lfochamon/protoarray/Hardware/pics/DSC_0234.jpg

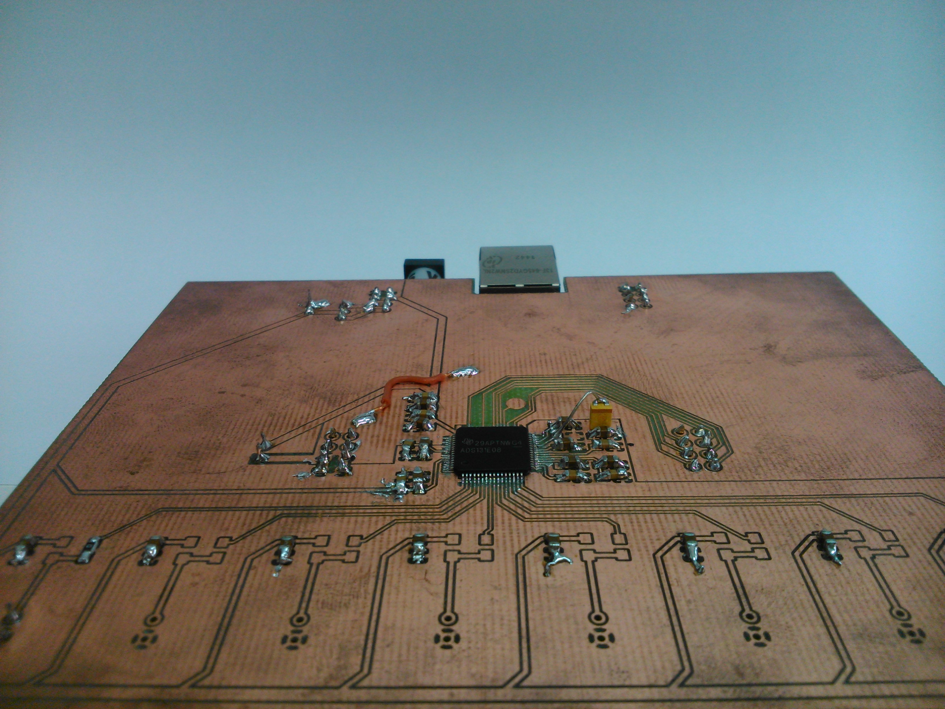
Hardware/pics/DSC_0234.jpg
