lfochamon/protoarray/Hardware/pics/DSC_0238.jpg

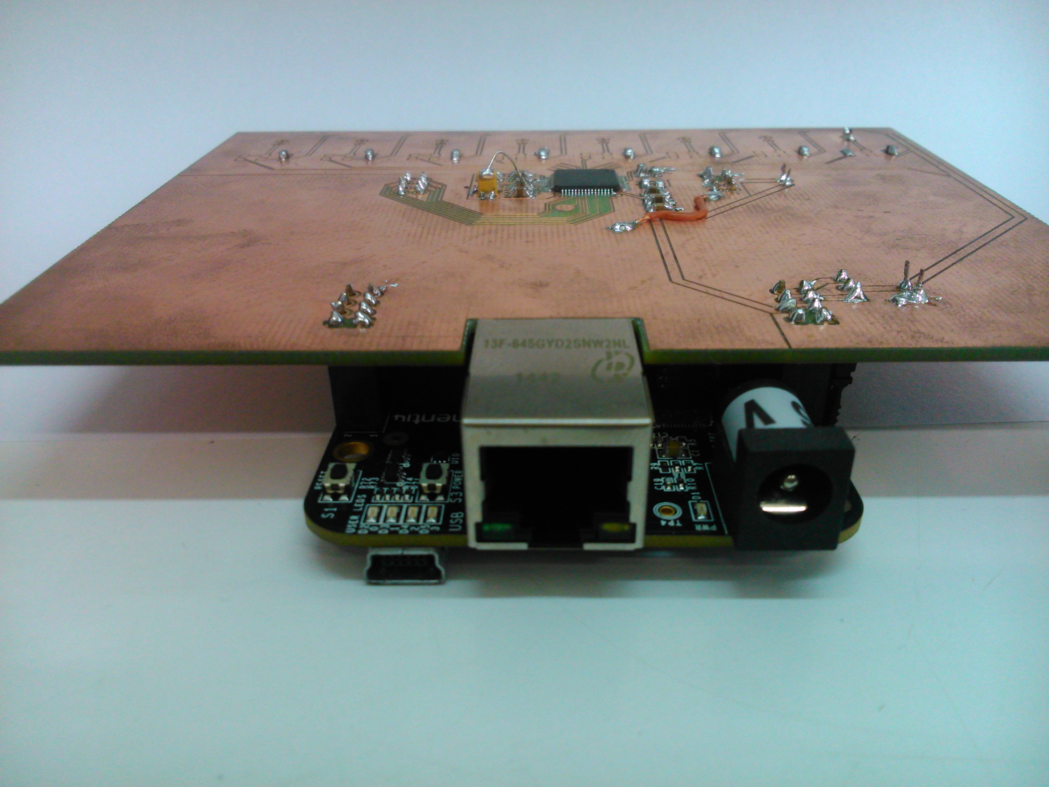
Hardware/pics/DSC_0238.jpg
