lfochamon/protoarray/README.md

# ProtoArray: A prototype microphone array for the BeagleBone Black

This repository contains a prototype ADS131E08 cape for the BBB to be used as a microphone array (or whatever).
