lfochamon/protoarray/Hardware/pics/DSC_0229.jpg

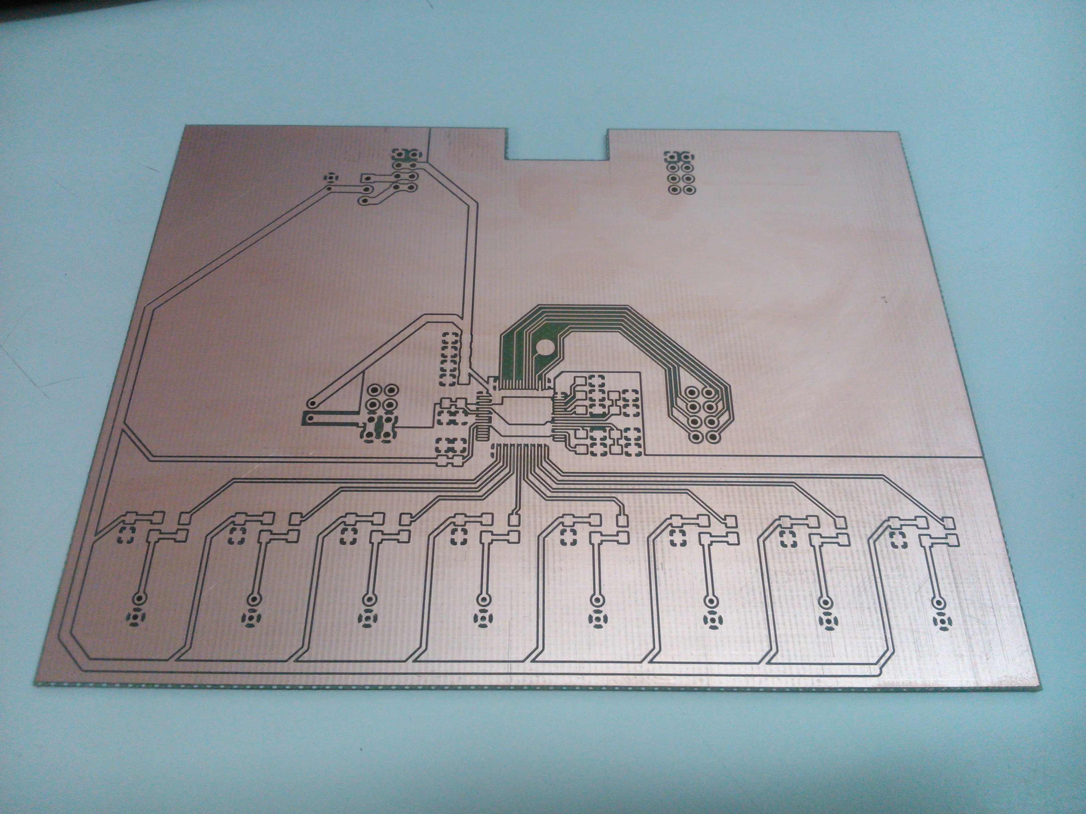
Hardware/pics/DSC_0229.jpg
