lfochamon/protoarray/Hardware/pics/DSC_0231.jpg

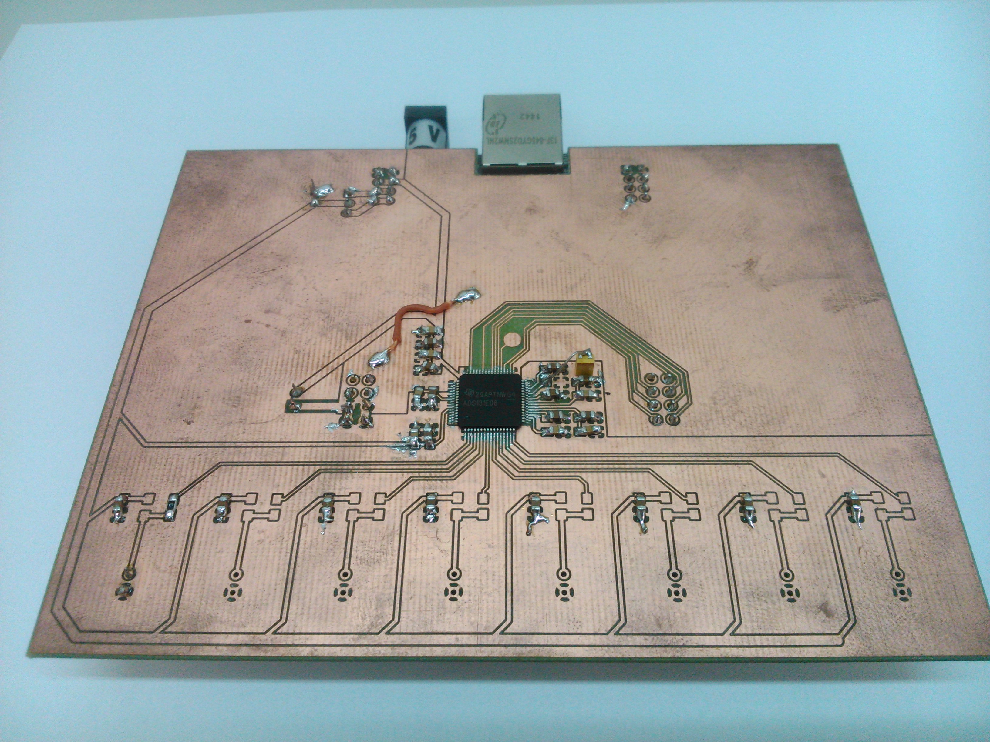
Hardware/pics/DSC_0231.jpg
