lfochamon/protoarray/Hardware/pics/DSC_0240.jpg

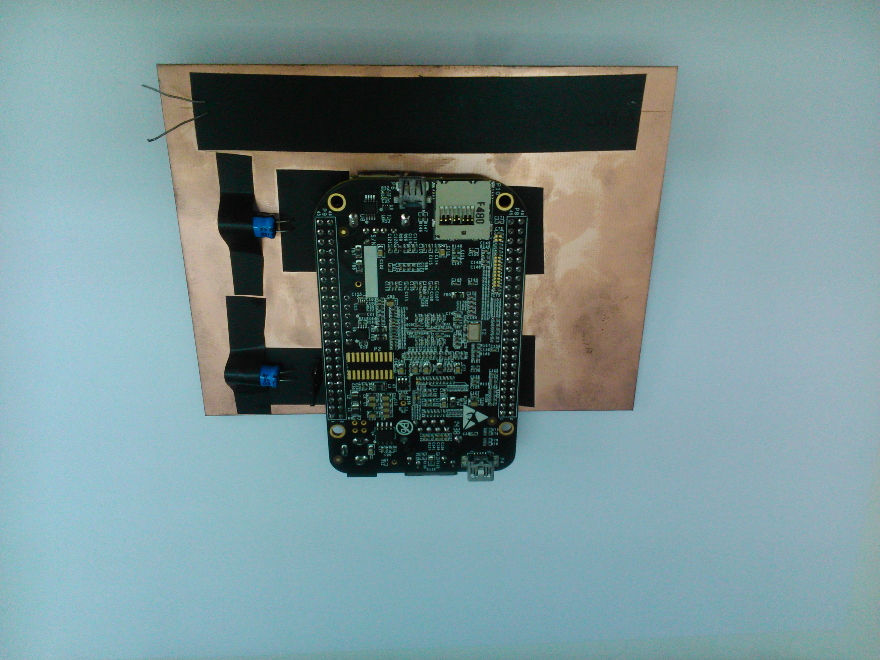
Hardware/pics/DSC_0240.jpg
