lfochamon/protoarray/Hardware/pics/DSC_0241.jpg

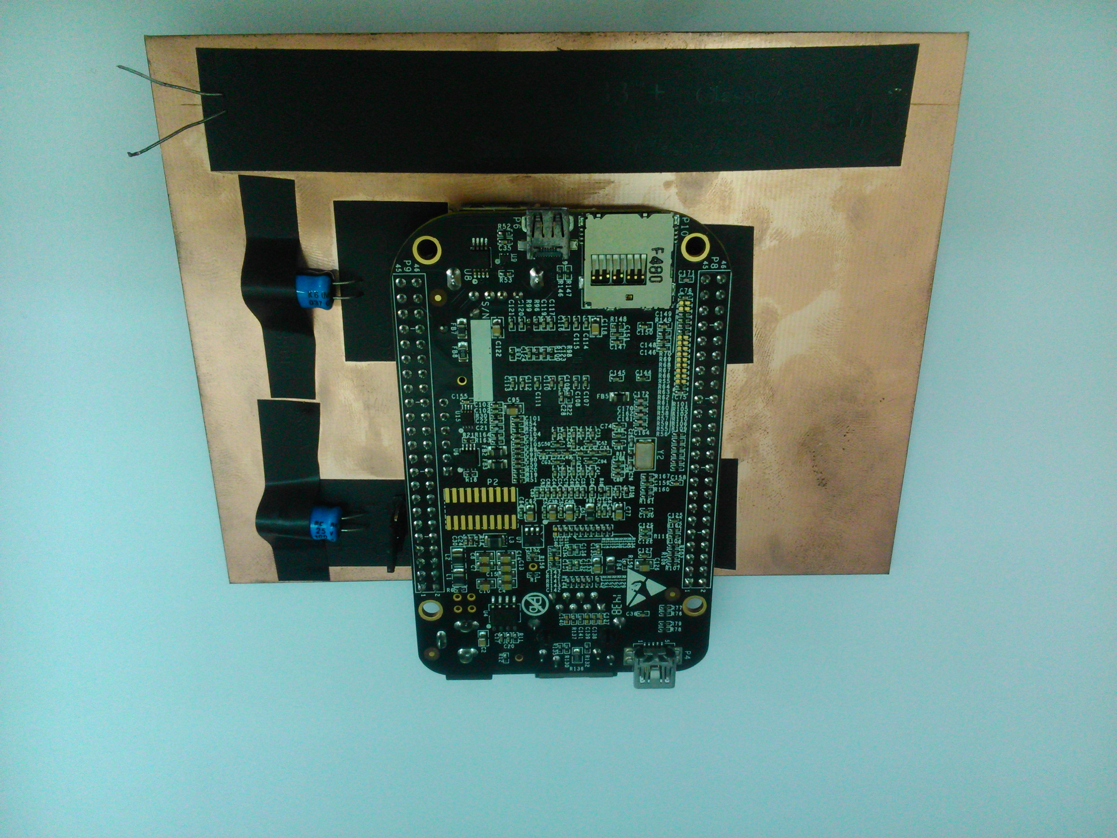
Hardware/pics/DSC_0241.jpg
