lfochamon/protoarray/Hardware/gerber/proto_array-PCB.pdf

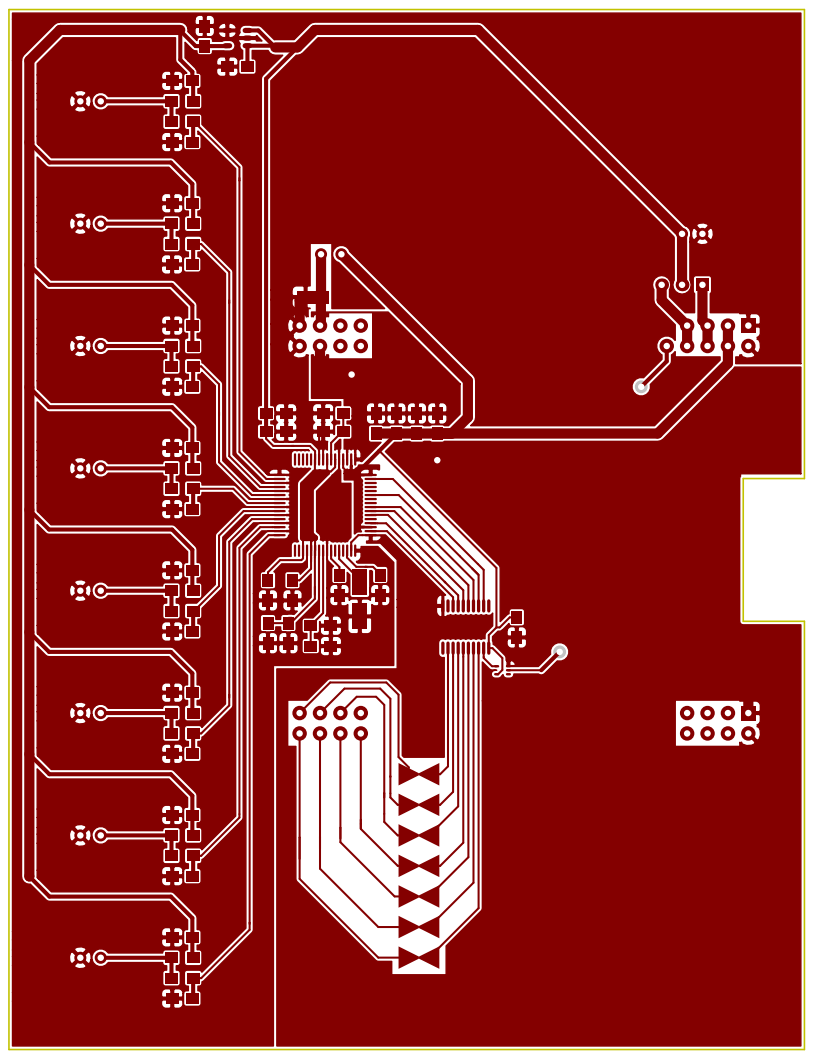
[picture p7: page 1]

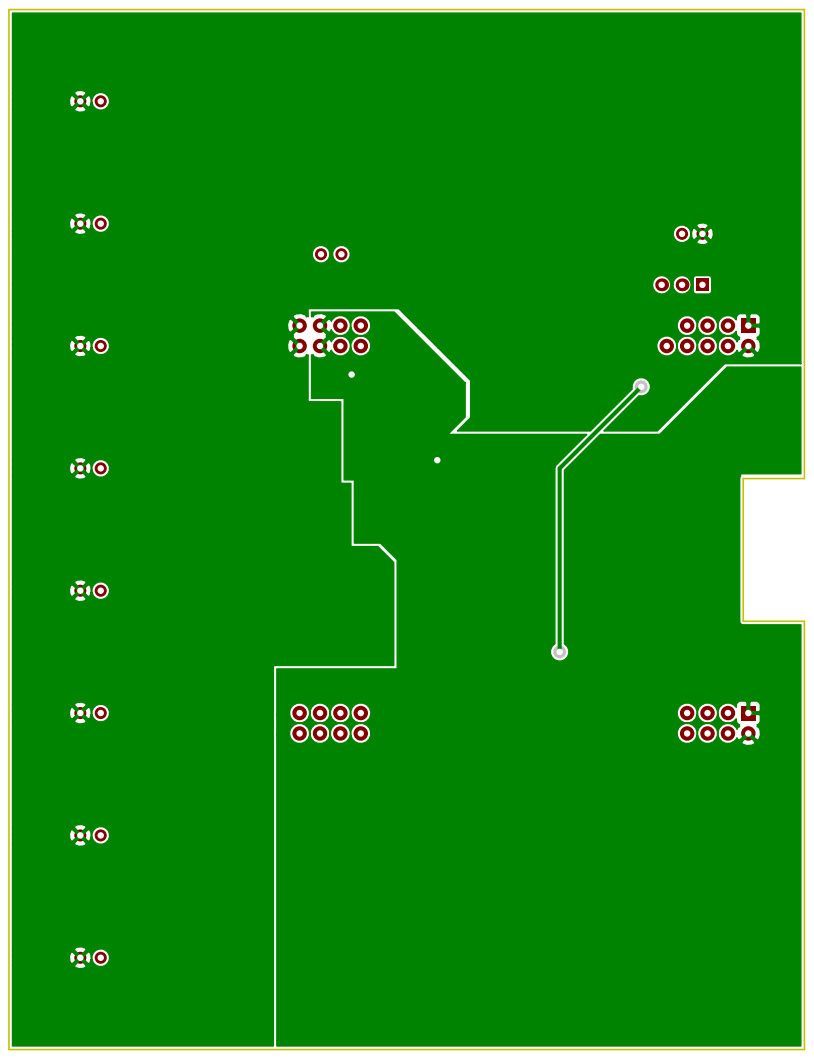
[picture p8: page 2]

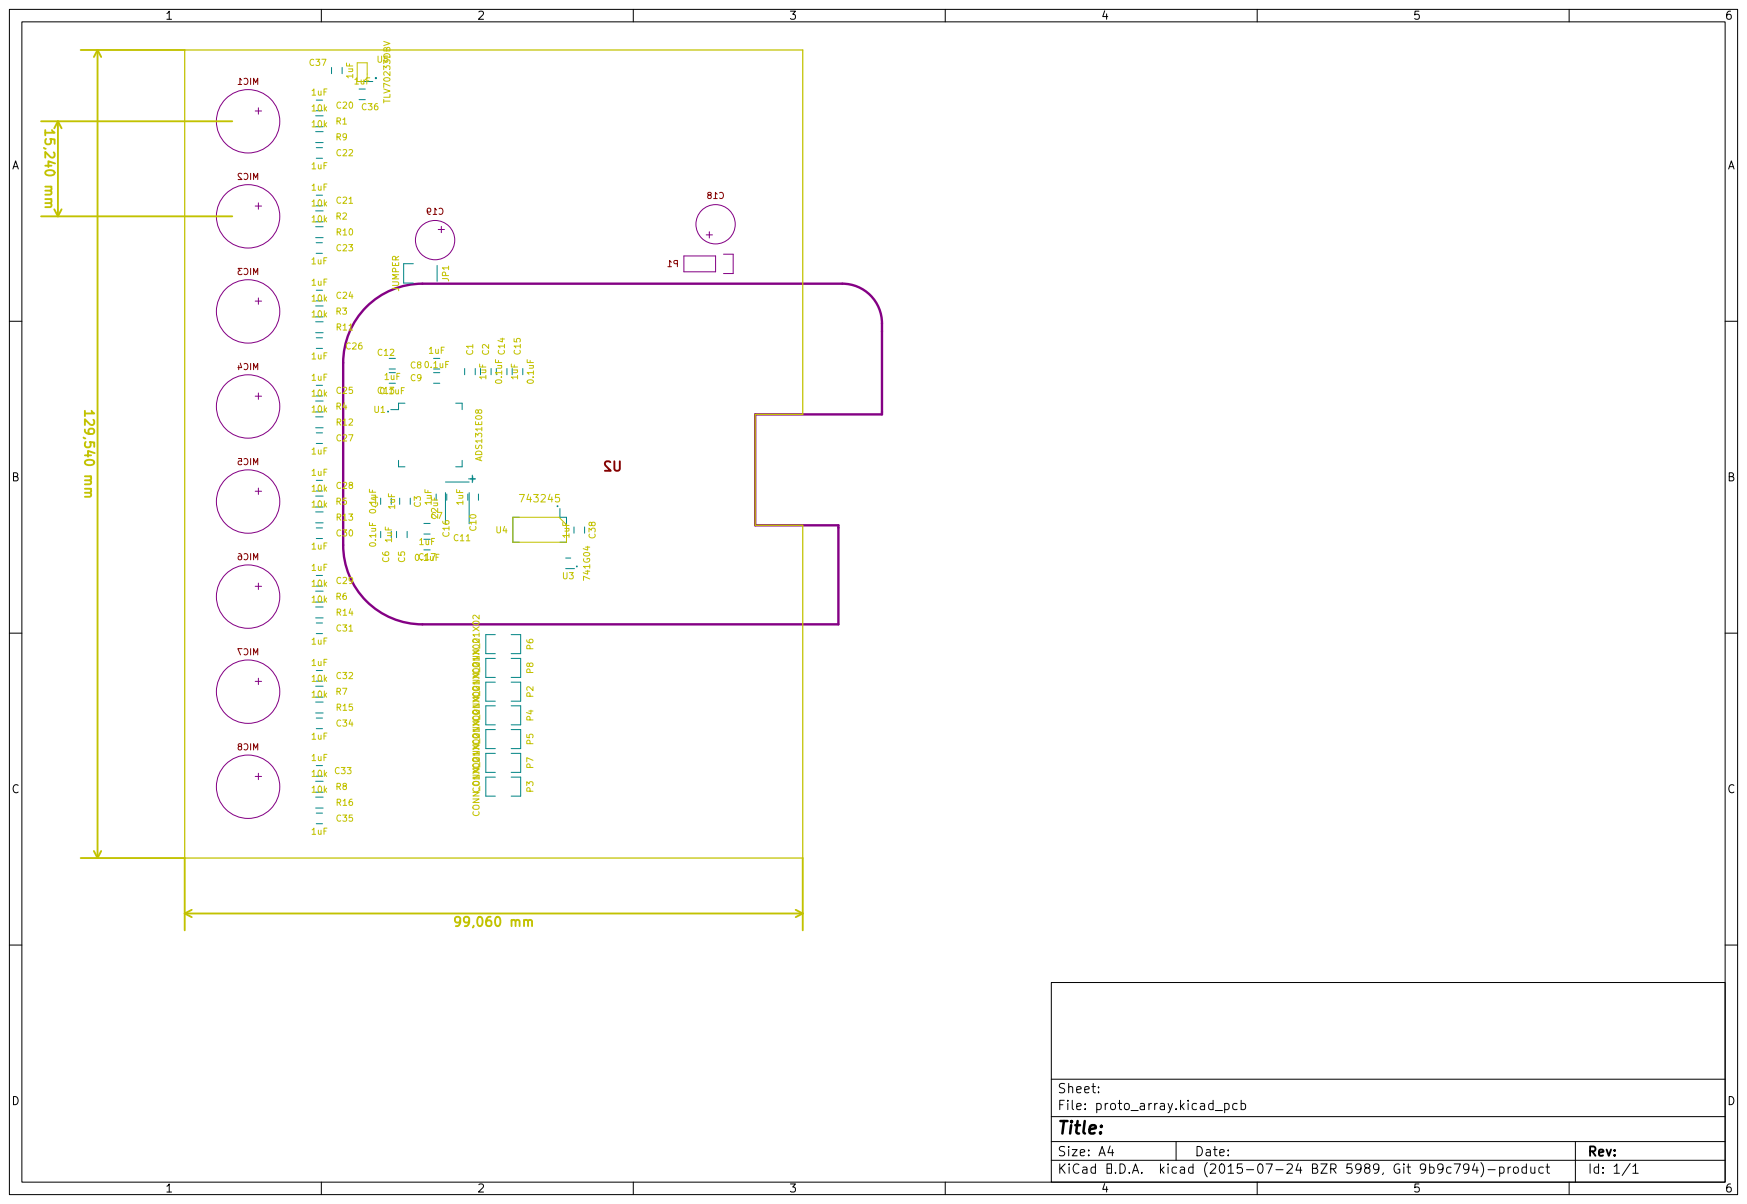
[picture p9: page 3]
