lfochamon/protoarray/Hardware/proto_array.kicad_pcb

## KiCad design Hardware/proto_array.kicad_pcb (2016-02-21)

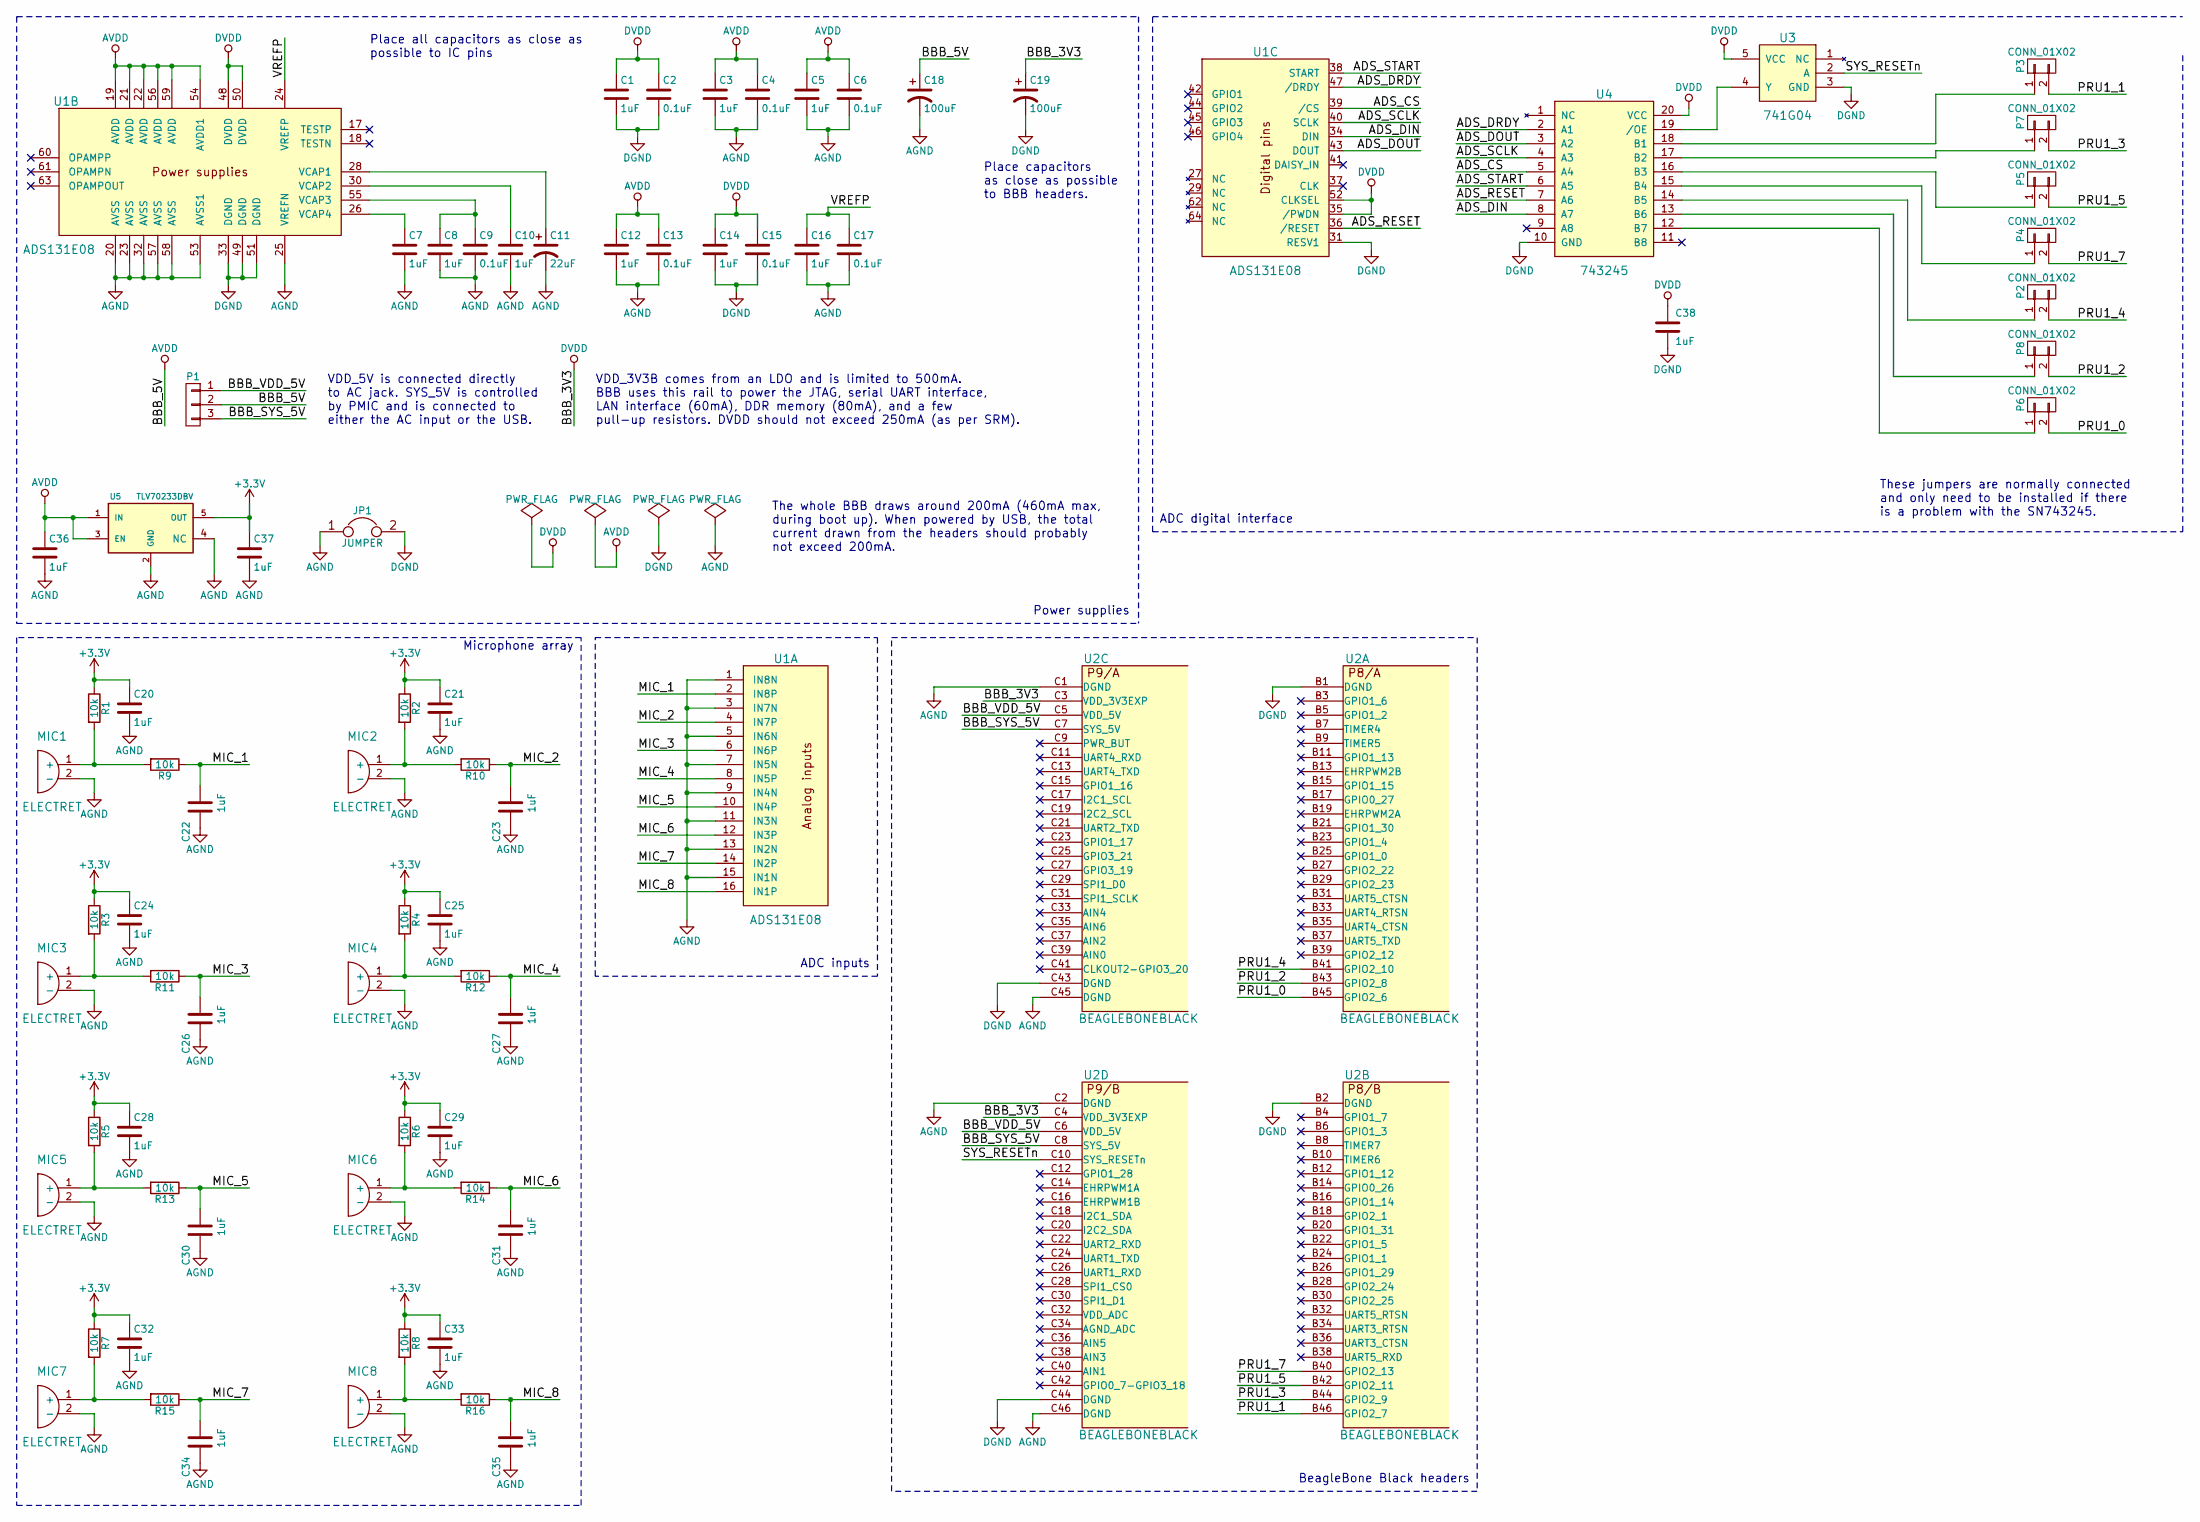
[picture p10: schematic proto_array.sch, Mic array prototype]

Parts:
C1, C3, C5, C7, C8, C10, C12, C14, C16, C20, C21, C22, C23, C24, C25, C26, C27, C28, C29, C30, C31, C32, C33, C34, C35, C36, C37, C38: 1uF; C_0805_HandSoldering
C2, C4, C6, C9, C13, C15, C17: 0.1uF; C_0805_HandSoldering
C11: 22uF; TantalC_SizeB_EIA-3528_HandSoldering
C18, C19: 100uF; Elko_vert_11.2x6.3mm_RM2.5_CopperClear
JP1: JUMPER; Jumper
MIC1, MIC2, MIC3, MIC4, MIC5, MIC6, MIC7, MIC8: ELECTRET; Electret_1mm
P1: CONN_01X03; Pin_Header_01x03
P2, P3, P4, P5, P6, P7, P8: CONN_01X02; Pin_Header_NC_01x02
R1, R2, R3, R4, R5, R6, R7, R8, R9, R10, R11, R12, R13, R14, R15, R16: 10k; R_0805_HandSoldering
U1: ADS131E08; LQFP-64_12x12_Pitch0.5mm_NoFid
U2: BEAGLEBONEBLACK; beagleboneblack_custom
U3: 741G04; SOTFL-5_160x50_Pitch0.5
U4: 743245; SOP-20_600x175_Pitch0.635
U5: TLV70233DBV; SOT-23-5

Connections:
+3V3: C20.1, C21.1, C24.1, C25.1, C28.1, C29.1, C32.1, C33.1, C37.1, R1.1, R2.1, R3.1, R4.1, R5.1, R6.1, R7.1, R8.1, U5.5 (OUT)
/ADS_CS: U1.39 (/CS), U4.5 (A4)
/ADS_DIN: U1.34 (DIN), U4.8 (A7)
/ADS_DOUT: U1.43 (DOUT), U4.3 (A2)
/ADS_DRDY: U1.47 (/DRDY), U4.2 (A1)
/ADS_RESET: U1.36 (/RESET), U4.7 (A6)
/ADS_SCLK: U1.40 (SCLK), U4.4 (A3)
/ADS_START: U1.38 (START), U4.6 (A5)
/BBB_SYS_5V: P1.3, U2.C7 (SYS_5V), U2.C8 (SYS_5V)
/BBB_VDD_5V: P1.1, U2.C5 (VDD_5V), U2.C6 (VDD_5V)
/MIC_1: C22.2, R9.1, U1.2 (IN8P)
/MIC_2: C23.2, R10.1, U1.4 (IN7P)
/MIC_3: C26.2, R11.1, U1.6 (IN6P)
/MIC_4: C27.2, R12.1, U1.8 (IN5P)
/MIC_5: C30.2, R13.1, U1.10 (IN4P)
/MIC_6: C31.2, R14.1, U1.12 (IN3P)
/MIC_7: C34.2, R15.1, U1.14 (IN2P)
/MIC_8: C35.2, R16.1, U1.16 (IN1P)
/PRU1_0: P6.2, U2.B45 (GPIO2_6)
/PRU1_1: P3.2, U2.B46 (GPIO2_7)
/PRU1_2: P8.2, U2.B43 (GPIO2_8)
/PRU1_3: P7.2, U2.B44 (GPIO2_9)
/PRU1_4: P2.2, U2.B41 (GPIO2_10)
/PRU1_5: P5.2, U2.B42 (GPIO2_11)
/PRU1_7: P4.2, U2.B40 (GPIO2_13)
/SYS_RESETn: U2.C10 (SYS_RESETn), U3.2 (A)
/VREFP: C16.1, C17.1, U1.24 (VREFP)
AGND: C3.2, C4.2, C5.2, C6.2, C7.2, C8.2, C9.2, C10.2, C11.2, C12.2, C13.2, C16.2, C17.2, C18.2, C20.2, C21.2, C22.1, C23.1, C24.2, C25.2, C26.1, C27.1, C28.2, C29.2, C30.1, C31.1, C32.2, C33.2, C34.1, C35.1, C36.2, C37.2, JP1.1, MIC1.2 (-), MIC2.2 (-), MIC3.2 (-), MIC4.2 (-), MIC5.2 (-), MIC6.2 (-), MIC7.2 (-), MIC8.2 (-), U1.1 (IN8N), U1.3 (IN7N), U1.5 (IN6N), U1.7 (IN5N), U1.9 (IN4N), U1.11 (IN3N), U1.13 (IN2N), U1.15 (IN1N), U1.20 (AVSS), U1.23 (AVSS), U1.25 (VREFN), U1.32 (AVSS), U1.53 (AVSS1), U1.57 (AVSS), U1.58 (AVSS), U2.C1 (DGND), U2.C2 (DGND), U2.C45 (DGND), U2.C46 (DGND), U5.2 (GND), U5.4 (NC)
AVDD: C3.1, C4.1, C5.1, C6.1, C12.1, C13.1, C18.1, C36.1, P1.2, U1.19 (AVDD), U1.21 (AVDD), U1.22 (AVDD), U1.54 (AVDD1), U1.56 (AVDD), U1.59 (AVDD), U5.1 (IN), U5.3 (EN)
DGND: C1.2, C2.2, C14.2, C15.2, C19.2, C38.2, JP1.2, U1.31 (RESV1), U1.33 (DGND), U1.49 (DGND), U1.51 (DGND), U2.B1 (DGND), U2.B2 (DGND), U2.C43 (DGND), U2.C44 (DGND), U3.3 (GND), U4.10 (GND)
DVDD: C1.1, C2.1, C14.1, C15.1, C19.1, C38.1, U1.35 (/PWDN), U1.48 (DVDD), U1.50 (DVDD), U1.52 (CLKSEL), U2.C3 (VDD_3V3EXP), U2.C4 (VDD_3V3EXP), U3.5 (VCC), U4.20 (VCC)
unnamed: C7.1, U1.26 (VCAP4)
unnamed: C8.1, C9.1, U1.55 (VCAP3)
unnamed: C10.1, U1.30 (VCAP2)
unnamed: C11.1, U1.28 (VCAP1)
unnamed: MIC1.1 (+), R1.2, R9.2
unnamed: MIC2.1 (+), R2.2, R10.2
unnamed: MIC3.1 (+), R3.2, R11.2
unnamed: MIC4.1 (+), R4.2, R12.2
unnamed: MIC5.1 (+), R5.2, R13.2
unnamed: MIC6.1 (+), R6.2, R14.2
unnamed: MIC7.1 (+), R7.2, R15.2
unnamed: MIC8.1 (+), R8.2, R16.2
unnamed: P2.1, U4.14 (B5)
unnamed: P3.1, U4.18 (B1)
unnamed: P4.1, U4.15 (B4)
unnamed: P5.1, U4.16 (B3)
unnamed: P6.1, U4.12 (B7)
unnamed: P7.1, U4.17 (B2)
unnamed: P8.1, U4.13 (B6)
unnamed: U3.4 (Y), U4.19 (/OE)

Notes on the sheet:
Place all capacitors as close as possible to IC pins
Power supplies
Microphone array
ADC inputs
BeagleBone Black headers
ADC digital interface
VDD_5V is connected directly to AC jack. SYS_5V is controlled by PMIC and is connected to either the AC input or the USB.
VDD_3V3B comes from an LDO and is limited to 500mA. BBB uses this rail to power the JTAG, serial UART interface, LAN interface (60mA), DDR memory (80mA), and a few pull-up resistors. DVDD should not exceed 250mA (as per SRM).
The whole BBB draws around 200mA (460mA max, during boot up). When powered by USB, the total current drawn from the headers should probably not exceed 200mA.
Place capacitors as close as possible to BBB headers.
These jumpers are normally connected and only need to be installed if there is a problem with the SN743245.

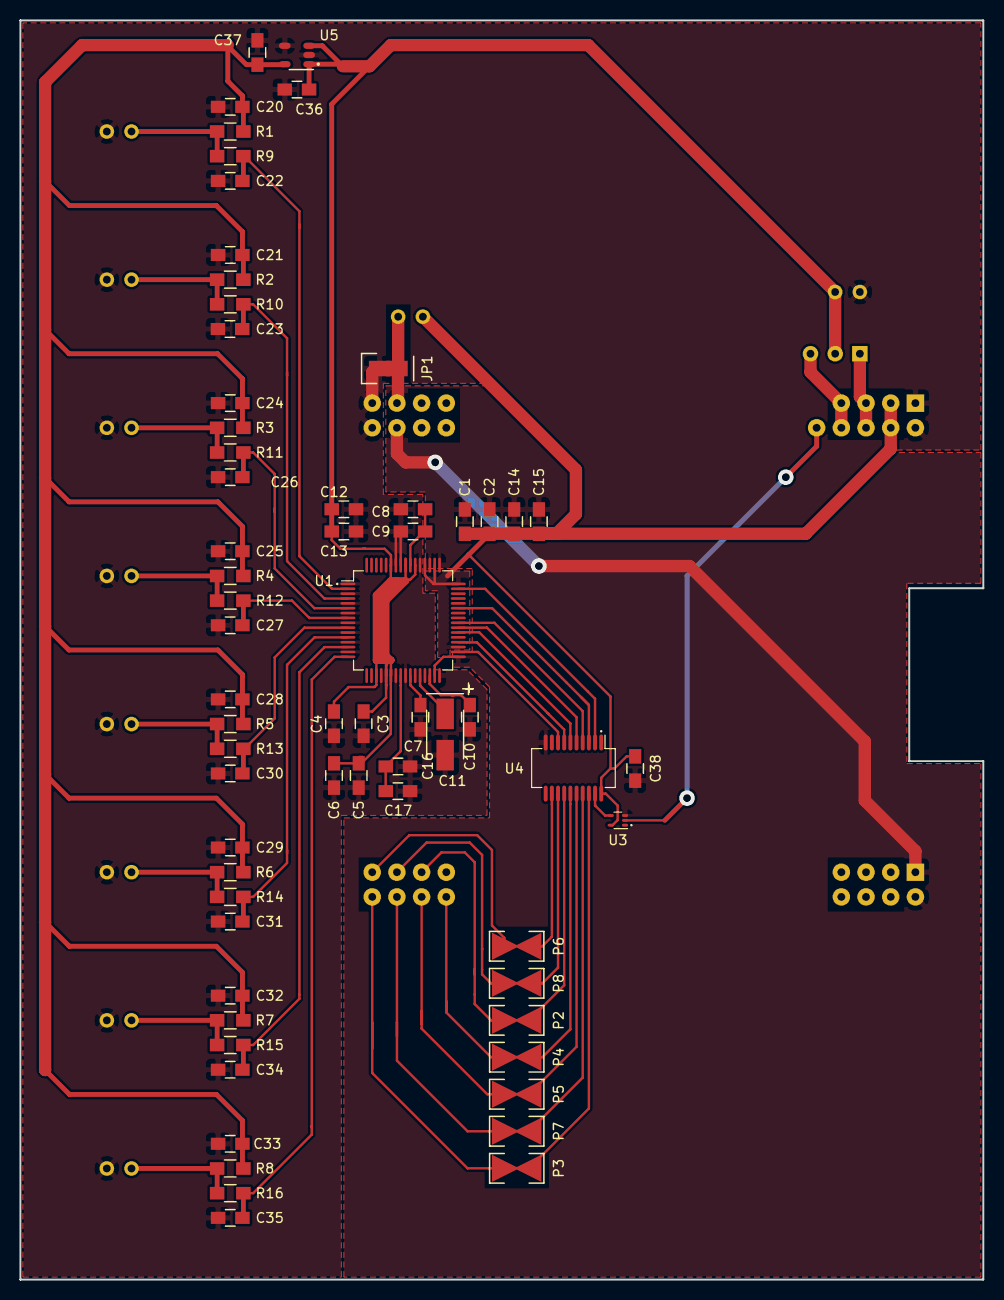
[picture p11: board proto_array.kicad_pcb from above]

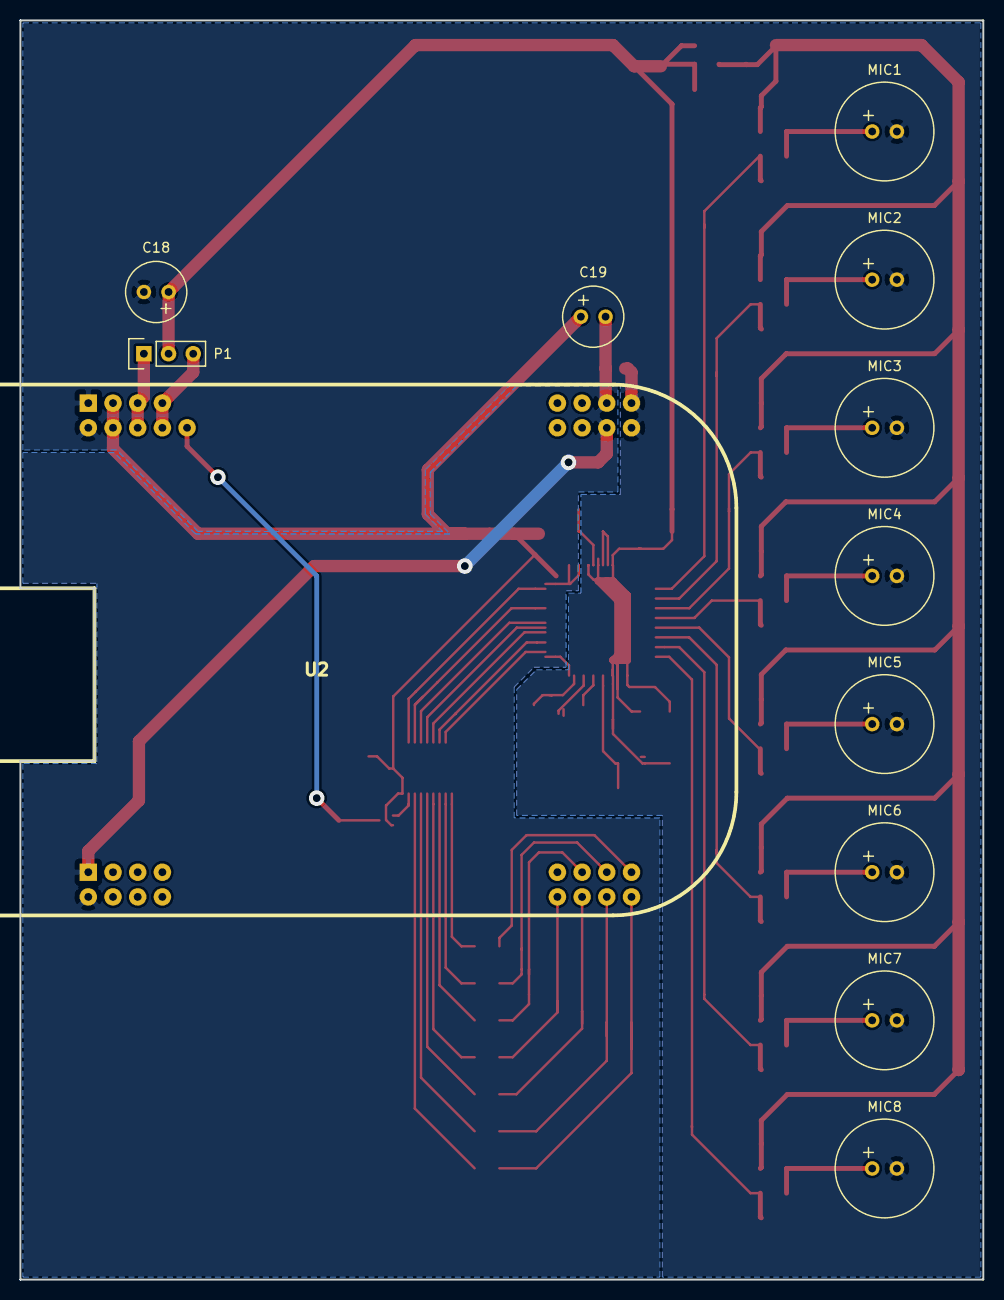
[picture p12: board proto_array.kicad_pcb from below]

Board: 2 copper layers, 99.1 x 129.5 mm, 76 parts (12 on the bottom side), 51 nets.
