lfochamon/protoarray/(commit log)

2015-06-02 First commit. Schematic for mic array prototype with BBB.
    [proto_array.sch]
2015-06-24 Rewrite in TI's compiler assembly language.
2015-06-25 Fix assembly to be compatible with TI's compiler.
    * Fix assembly to be compatible with TI's compiler.
    + Fix error in loop filling logic.
2015-06-25 Fix assembly errors.
    * Fix interrupt register (r30 -> r31);
    * Use & before registers used as pointers;
    * Change dummy data;
    * Fix delay loop label.
2015-06-25 Fix compile warnings and errors.
    [main.c]
2015-06-25 Remove socketInfo function.
2015-06-25 Fix pru functions having useless side-effects.
    * pru_start no longer prints error message: leave that to the library user.
2015-07-02 Fix IC name from ADI131 to ADS131 in code.
    [main.c]
2015-07-02 Rename files with correct IC name (ADI -> ADS).
    [ads131e08_pru0.asm, ads131e08_pru1.asm]
2015-07-02 Include Device Tree Overlay for the array.
2015-07-03 Fix comments and formatting.
    [ads131e08_pru0.asm, ads131e08_pru1.asm]
2015-07-03 Fix number of bytes to import from scratchpad.
    [ads131e08_pru0.asm]
2015-07-16 Small fixes in host program.
    [main.c]
2015-07-16 Import ADS driver library.
    Import ADS driver library from https://github.com/lchamon/beagleads131.
2015-07-17 Update ADS driver library.
2015-07-18 Footprint association.
2015-07-18 PCB design.
    [proto_array.kicad_pcb]
2015-07-18 Eliminated the headers for SPI interface to make PCB single layer.
    [proto_array.kicad_pcb, proto_array.sch]
2015-07-18 Routed AVDD. Trying to solve ground routing.
    [proto_array.kicad_pcb]
2015-07-18 * Fix PRU connections on the schematic * Reduce microphone tracks to fit ground plane * Remove fiducials from ADC IC
    [proto_array.kicad_pcb, proto_array.sch]
2015-07-18 Final PCB with one airwire.
    [proto_array.kicad_pcb, proto_array.sch]
2015-07-18 * Add ADC footprint without fiducials * Remove unused pin headers from BBB * Modify eletret footprint
    [proto_array.kicad_pcb, proto_array.sch]
2015-07-18 Final board version...
    * Fix ADC net DRC (clearance: 8 mils)
    * Fix a few track-pad clearance violations
    * Fix ground plane pours
    [proto_array.kicad_pcb]
2015-07-18 Erase SPI remaining net labels and fix unconnected pins error in schematics.
    [proto_array.sch]
2015-07-18 Unify drill sizes (all drilling in 0.8 mm).
    [proto_array.kicad_pcb, proto_array.sch]
2015-07-18 Generate gerber files and PCB image/place.
    [proto_array-Edge_Cuts.gbr, proto_array-F_Cu.gtl, proto_array-F_Mask.gts, proto_array-F_SilkS.gto, proto_array.drl]
2015-07-18 Update tantalum capacitor (C11) package.
    [proto_array.kicad_pcb, proto_array.sch]
2015-07-21 Update ADS driver library to import new fixes.
2015-07-21 Fix footprint for header 1x3 and add header 1x2.
2015-07-21 Remove test point and add header on PRU pins.
    [proto_array.sch]
2015-07-21 Update PCB.
    * Remove test point
    * Add header to PRU pins
    [proto_array.kicad_pcb]
2015-07-24 Include switch for SYSBOOT pins and fix mic powering.
    [proto_array.sch]
2015-07-24 Add SN743245 and TLV702 footprints to library.
2015-07-27 Add 741G04 and normally connected jumper footprints.
2015-07-27 Update footprints in the schematics.
    [proto_array.sch]
2015-07-27 Remove NI resistors and include jumper between GNDs.
    [proto_array.sch]
2015-07-27 Fix NC jumper and custom BBB footprints.
2015-07-27 Add bypass to 743245 and fix pinout of 741G04.
    [proto_array.sch]
2015-07-27 Fix clearance on jumper and NC header footprints.
2015-07-27 Update PCB with new changes in schematics.
    [proto_array.kicad_pcb]
2015-07-28 Fix jumper footprint clearances. Still a few DRC warnings.
    [proto_array.kicad_pcb]
2015-07-28 Generate new gerbers.
    [proto_array-B_Cu.gbl, proto_array-B_Mask.gbs, proto_array-B_SilkS.gbo, proto_array-Edge_Cuts.gbr, proto_array-Edge_Cuts.gm1, proto_array-F_Cu.gtl, proto_array-F_Mask.gts, proto_array-F_SilkS.gto]
2015-08-14 Fix issue with TLV schematic symbol.
    [proto_array.sch]
2016-02-21 Move files into /Hardware folder.
    [proto_array.csv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]
2016-02-21 Move host program prototypes to /Software folder.
2016-02-21 Add pictures of prototype PCB.
